burakBoyuk/gomulu-sistemler-kart/LICENSES/README.md

# Lisanslar

| Kapsam | Lisans | Dosya |
|---|---|---|
| Donanım (`hardware/`: şematik, PCB, BOM, üretim dosyaları) | CERN-OHL-P-2.0 | [`../LICENSE`](../LICENSE) |
| Yazılım (`firmware/`) | MIT | [`MIT.txt`](MIT.txt) |
| Doküman ve görseller (`docs/`, README) | CC BY 4.0 | [`CC-BY-4.0.txt`](CC-BY-4.0.txt) |

Telif: © 2026 Burak Kaan Böyük
