burakBoyuk/gomulu-sistemler-kart/hardware/es_brd_v000/es_brd_v000.csv

Reference | Qty | Value | Footprint | Link
C1,C3,C4,C6,C8,C9,C10,C13 | 8 | 100nF | Capacitor_SMD:C_0603_1608Metric | https://www.ozdisan.com/p/smt-smd-ve-mlcc-kapasitorler-184/samsung-cl10b104kb8nnnc-9739
C2,C5 | 2 | 220uF | Capacitor_SMD:CP_Elec_6.3x7.7 | https://www.ozdisan.com/p/aluminyum-kapasitorler-180/suscon-cd010m221e7dpkkkv00r-983562
C7,C11 | 2 | 18pF | Capacitor_SMD:C_0603_1608Metric | https://www.ozdisan.com/p/smt-smd-ve-mlcc-kapasitorler-184/viking-mcf03jtn500180-1086149
C12,C14 | 2 | 10uF | Capacitor_SMD:C_0603_1608Metric | https://www.ozdisan.com/p/smt-smd-ve-mlcc-kapasitorler-184/viking-mcf03mtx250106-1057176
D1 | 1 | LED_RED | LED_SMD:LED_0603_1608Metric | https://www.ozdisan.com/p/sinyal-ledler-tek-renkli-361/liteon-ltst-c190krkt-456428
D2 | 1 | LED_GRN | LED_SMD:LED_0603_1608Metric | https://www.ozdisan.com/p/sinyal-ledler-tek-renkli-361/liteon-ltst-c190krkt-456428
D3 | 1 | LED_BLE | LED_SMD:LED_0603_1608Metric | https://www.ozdisan.com/p/sinyal-ledler-tek-renkli-361/liteon-ltst-c190krkt-456428
D4 | 1 | LED_PWR | LED_SMD:LED_0603_1608Metric | https://www.ozdisan.com/p/sinyal-ledler-tek-renkli-361/liteon-ltst-c190krkt-456428
D5,D6 | 2 | M7 | Diode_SMD:D_SMA | https://www.ozdisan.com/p/dogrultucu-diyotlar-389/hottech-m7-ht-417206
J1 | 1 | Conn | Connector_JST:JST_XH_B2B-XH-A_1x02_P2.50mm_Vertical
J2 | 1 | SPI_CONN | Connector_PinHeader_2.54mm:PinHeader_1x04_P2.54mm_Vertical
J3 | 1 | PRG_CONN | Connector_PinHeader_2.54mm:PinHeader_1x04_P2.54mm_Vertical
J4 | 1 | I2C_CONN | Connector_JST:JST_XH_B4B-XH-A_1x04_P2.50mm_Vertical
J5 | 1 | PWR_CONN | Connector_PinHeader_2.54mm:PinHeader_1x04_P2.54mm_Vertical
J6 | 1 | PWR_IN | Connector_JST:JST_XH_S2B-XH-A_1x02_P2.50mm_Horizontal | https://www.ozdisan.com/p/pcb-konnektorler-310/connfly-ds1069-2mrw6sa-347995
J7 | 1 | RLY_OUT | Connector_Phoenix_MSTB:PhoenixContact_MSTBA_2,5_3-G-5,08_1x03_P5.08mm_Horizontal | https://www.ozdisan.com/p/gecmeli-klemensler-411/golten-2egtrc-5-08-03p-14-00ah-395410
K1 | 1 | HJR-3FF | Relay_THT:Relay_SPDT_SANYOU_SRD_Series_Form_C | https://www.ozdisan.com/p/genel-tip-roleler-403/tianbo-hjr-3ff-s-z-4-05vdc-415763
Q1 | 1 | BC817 | Package_TO_SOT_SMD:SOT-23 | https://www.ozdisan.com/p/discrete-transistorler-442/hottech-bc817-40-ht-417241
R1,R2,R3,R6,R7,R8,R10,R11,R12,R13 | 10 | 10K | Resistor_SMD:R_0603_1608Metric | https://www.ozdisan.com/p/smt-smd-ve-cip-direncler-194/royalohm-0603saj0103t5e-336243
R4,R5,R9,R15 | 4 | 1K | Resistor_SMD:R_0603_1608Metric | https://www.ozdisan.com/p/smt-smd-ve-cip-direncler-194/royalohm-0603saj0102t5e-336234
R14 | 1 | 330R | Resistor_SMD:R_0603_1608Metric | https://www.ozdisan.com/p/smt-smd-ve-cip-direncler-194/royalohm-0603saj0331t5e-336229
SW1 | 1 | BTN | Button_Switch_SMD:SW_SPST_Omron_B3FS-105xP
U1 | 1 | ATMEGA328PB-AU | Package_QFP:TQFP-32_7x7mm_P0.8mm | https://www.ozdisan.com/p/mikroislemciler-218/atmel-microchip-atmega328pb-au-537233
U2 | 1 | AMS1117-3.3 | Package_TO_SOT_SMD:SOT-223-3_TabPin2 | https://cdn.ozdisan.com/public/product/assets/AMS1117.pdf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
U3 | 1 | TMP1075D | Package_SO:SO-8_3.9x4.9mm_P1.27mm | https://www.ozdisan.com/p/sicaklik-sensorleri-927/texas-tmp1075dr-1086858
U4,U5 | 2 | LTV816 | Package_DIP:DIP-4_W7.62mm_SMDSocket_SmallPads | https://www.ozdisan.com/p/transistor-ve-fotovoltaik-cikisli-optokuplorler-189/liteon-ltv816s2tpc-v-g-951812
Y1 | 1 | 16MHz | Crystal:Crystal_SMD_3225-4Pin_3.2x2.5mm | https://www.ozdisan.com/p/kristaller-508/raltron-rh100-16-000-18-2020-tr-433869
