burakBoyuk/gomulu-sistemler-kart/docs/es_brd_v000-schematic.pdf

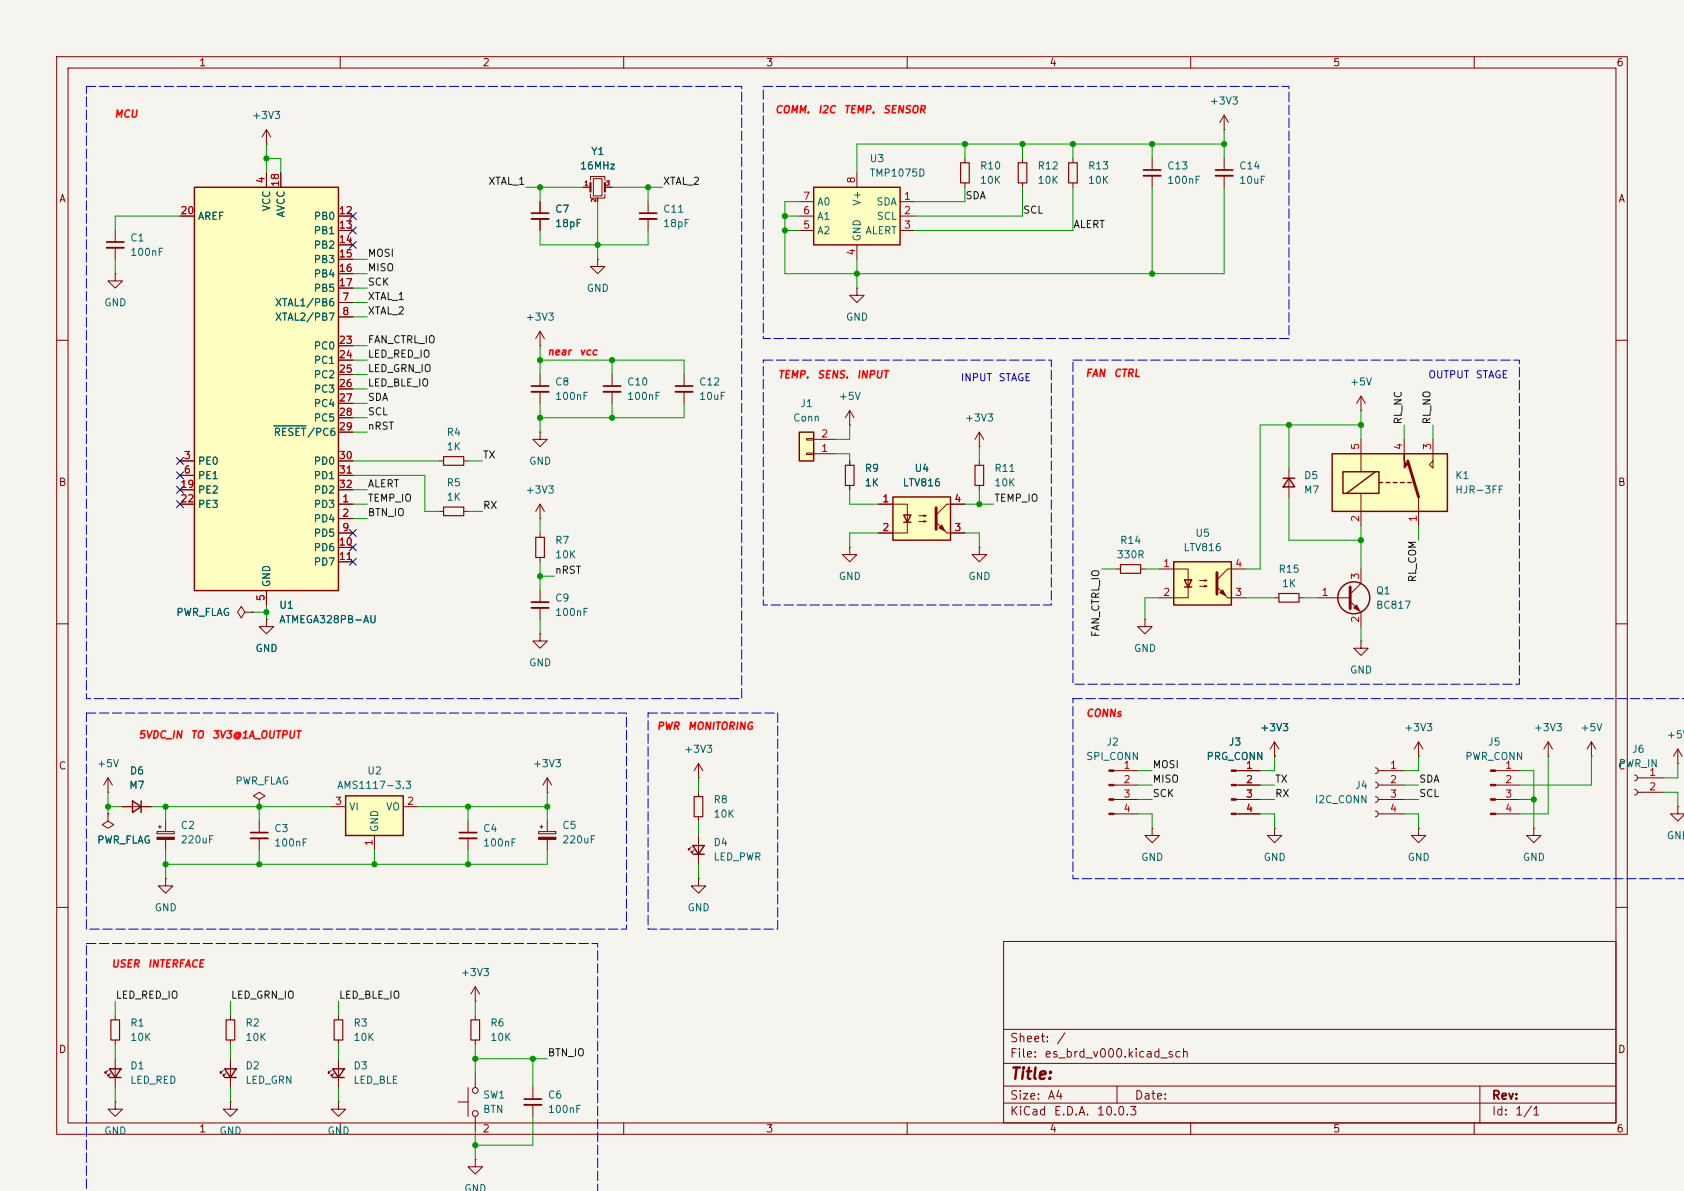
[picture p1: page 1]

Size: A4 | Rev:
KiCad E.D.A. 10.0.3 | Id: 1/1
