burakBoyuk/gomulu-sistemler-kart/hardware/es_brd_v000/es_brd_v000.kicad_pcb

## KiCad design hardware/es_brd_v000/es_brd_v000.kicad_pcb (2026-11-11)

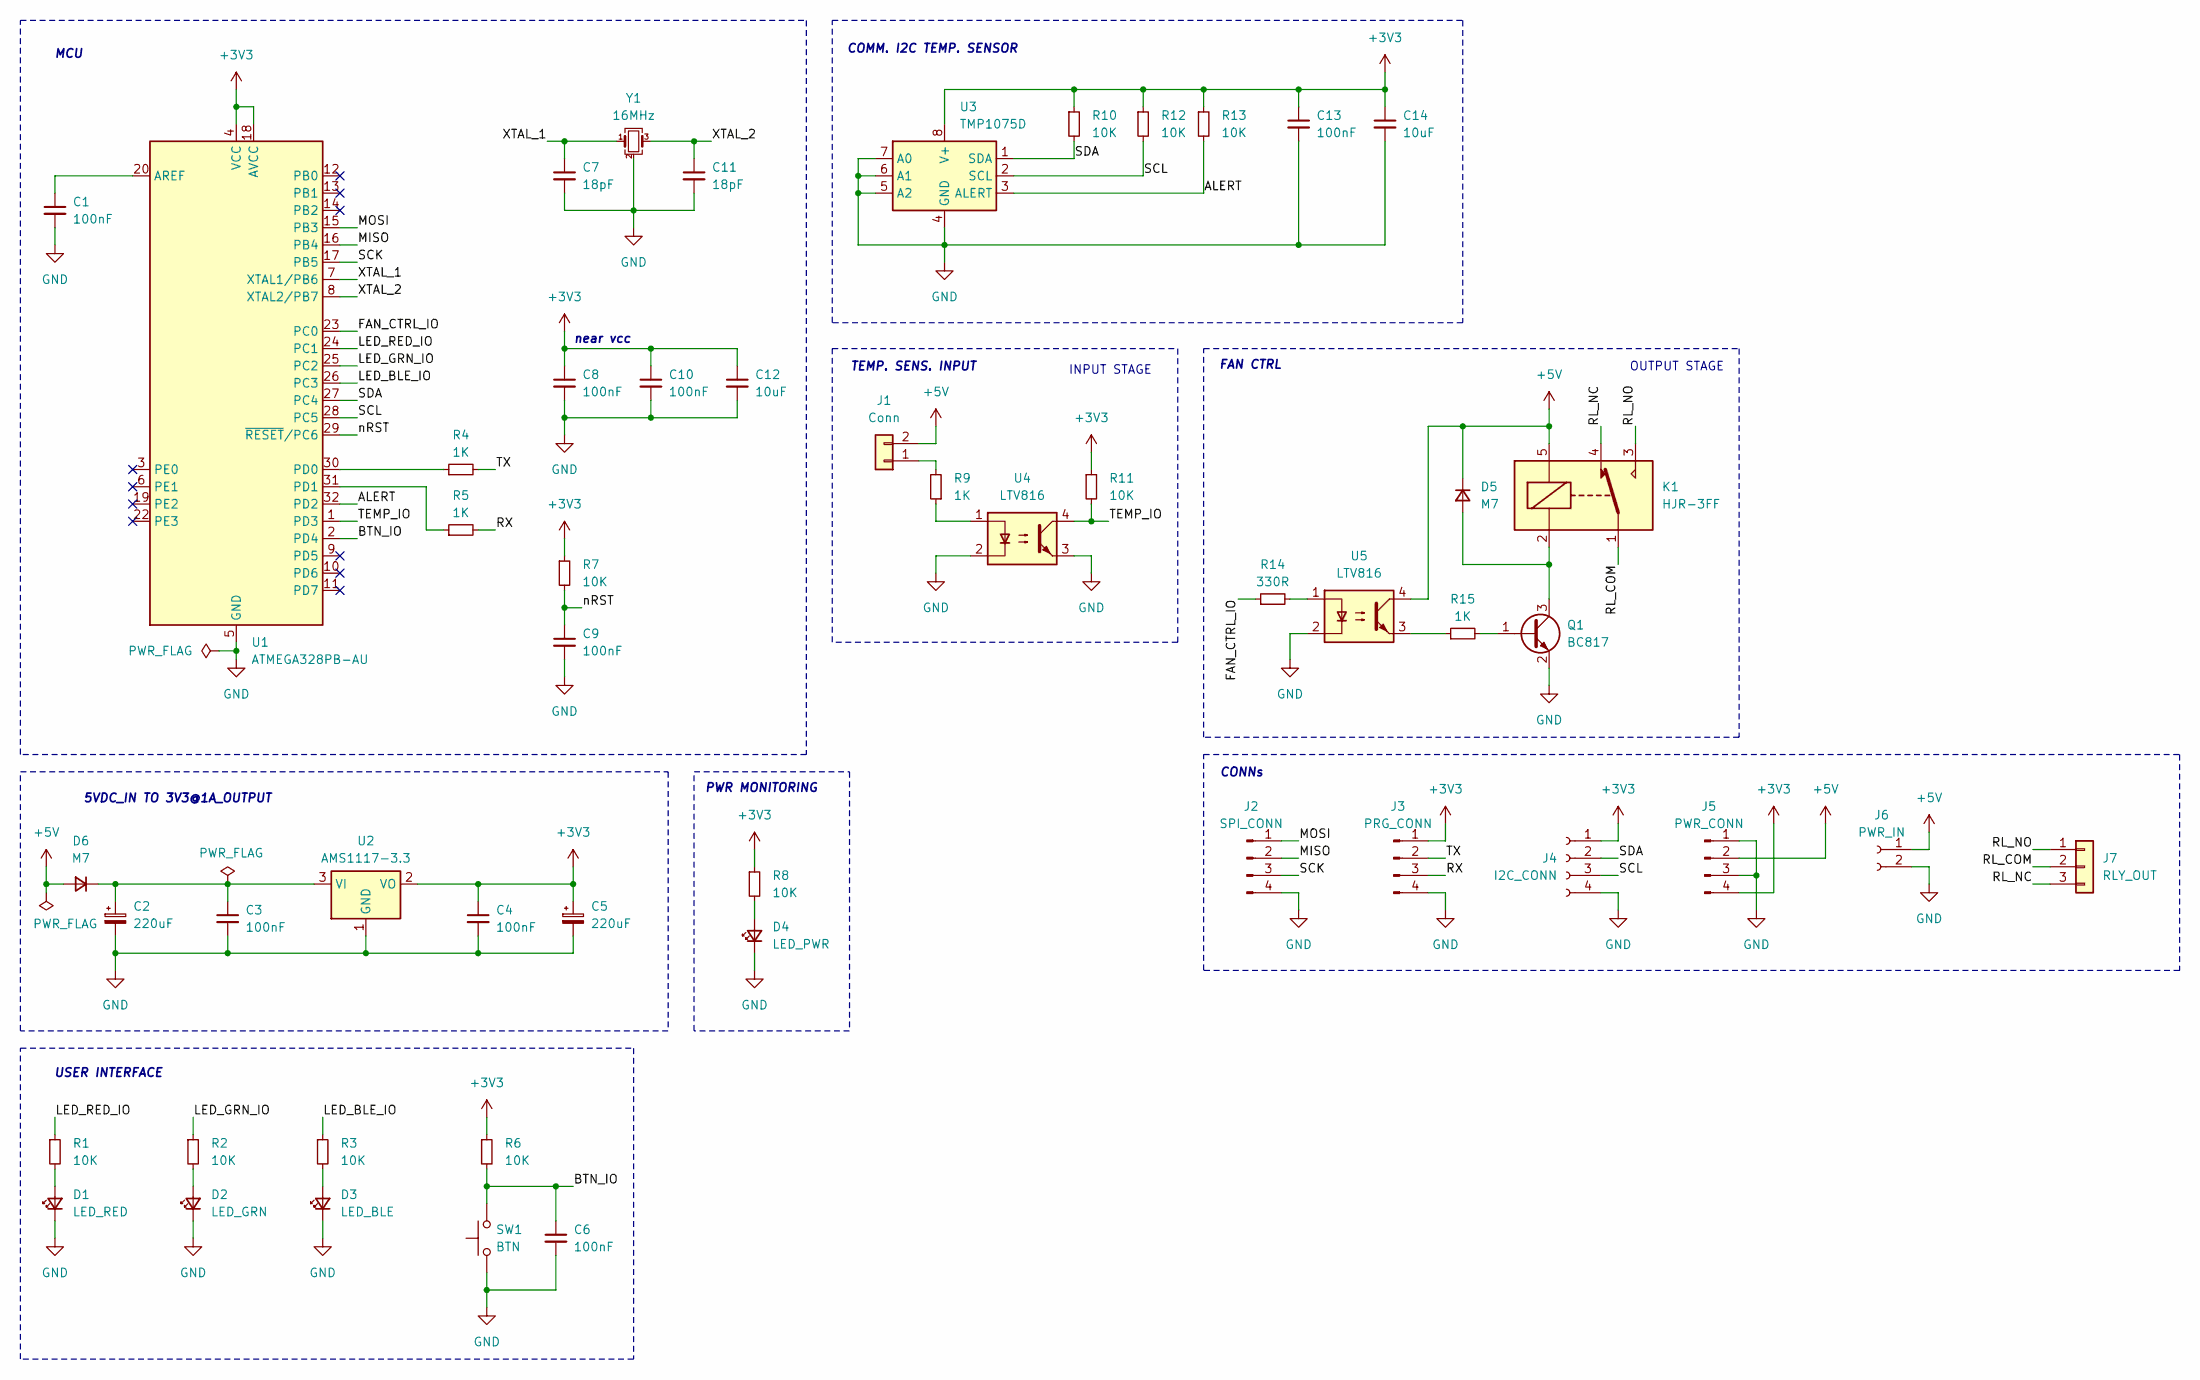
[picture p2: schematic es_brd_v000.kicad_sch]

Parts:
C1, C3, C4, C6, C8, C9, C10, C13: 100nF; C_0603_1608Metric
C2, C5: 220uF; CP_Elec_6.3x7.7
C7, C11: 18pF; C_0603_1608Metric
C12, C14: 10uF; C_0603_1608Metric
D1: LED_RED; LED_0603_1608Metric
D2: LED_GRN; LED_0603_1608Metric
D3: LED_BLE; LED_0603_1608Metric
D4: LED_PWR; LED_0603_1608Metric
D5, D6: M7; D_SMA
J1: Conn; JST_XH_B2B-XH-A_1x02_P2.50mm_Vertical
J2: SPI_CONN; PinHeader_1x04_P2.54mm_Vertical
J3: PRG_CONN; PinHeader_1x04_P2.54mm_Vertical
J4: I2C_CONN; JST_XH_B4B-XH-A_1x04_P2.50mm_Vertical
J5: PWR_CONN; PinHeader_1x04_P2.54mm_Vertical
J6: PWR_IN; JST_XH_S2B-XH-A_1x02_P2.50mm_Horizontal
J7: RLY_OUT; PhoenixContact_MSTBA_2,5_3-G-5,08_1x03_P5.08mm_Horizontal
K1: HJR-3FF; Relay_SPDT_SANYOU_SRD_Series_Form_C
Q1: BC817; SOT-23
R1, R2, R3, R6, R7, R8, R10, R11, R12, R13: 10K; R_0603_1608Metric
R4, R5, R9, R15: 1K; R_0603_1608Metric
R14: 330R; R_0603_1608Metric
SW1: BTN; SW_SPST_Omron_B3FS-105xP
U1: ATMEGA328PB-AU; TQFP-32_7x7mm_P0.8mm
U2: AMS1117-3.3; SOT-223-3_TabPin2
U3: TMP1075D; SO-8_3.9x4.9mm_P1.27mm
U4, U5: LTV816; DIP-4_W7.62mm_SMDSocket_SmallPads
Y1: 16MHz; Crystal_SMD_3225-4Pin_3.2x2.5mm

Connections:
+3V3: C4.1, C5.1, C8.1, C10.1, C12.1, C13.1, C14.1, J3.1, J4.1, J5.4, R6.1, R7.1, R8.1, R10.1, R11.1, R12.1, R13.1, U1.4 (VCC), U1.18 (AVCC), U2.2 (VO), U3.8 (V+)
+5V: D5.1 (K), D6.2 (A), J1.2, J5.2, J6.1, K1.5, U5.4
/ALERT: R13.2, U1.32 (PD2), U3.3 (ALERT)
/BTN_IO: C6.1, R6.2, SW1.2, U1.2 (PD4)
/FAN_CTRL_IO: R14.1, U1.23 (PC0)
/LED_BLE_IO: R3.1, U1.26 (PC3)
/LED_GRN_IO: R2.1, U1.25 (PC2)
/LED_RED_IO: R1.1, U1.24 (PC1)
/MISO: J2.2, U1.16 (PB4)
/MOSI: J2.1, U1.15 (PB3)
/RL_COM: J7.2, K1.1
/RL_NC: J7.3, K1.4
/RL_NO: J7.1, K1.3
/RX: J3.3, R5.2
/SCK: J2.3, U1.17 (PB5)
/SCL: J4.3, R12.2, U1.28 (PC5), U3.2 (SCL)
/SDA: J4.2, R10.2, U1.27 (PC4), U3.1 (SDA)
/TEMP_IO: R11.2, U1.1 (PD3), U4.4
/TX: J3.2, R4.2
/XTAL_1: C7.1, U1.7 (XTAL1/PB6), Y1.1
/XTAL_2: C11.1, U1.8 (XTAL2/PB7), Y1.3
/nRST: C9.1, R7.2, U1.29 (~RESET/PC6)
GND: C1.2, C2.2, C3.2, C4.2, C5.2, C6.2, C7.2, C8.2, C9.2, C10.2, C11.2, C12.2, C13.2, C14.2, D1.1 (K), D2.1 (K), D3.1 (K), D4.1 (K), J2.4, J3.4, J4.4, J5.1, J5.3, J6.2, Q1.2 (E), SW1.1, U1.5 (GND), U1.21 (GND), U2.1 (GND), U3.4 (GND), U3.5 (A2), U3.6 (A1), U3.7 (A0), U4.2, U4.3, U5.2, Y1.2 (G), Y1.4 (G)
unnamed: D1.2 (A), R1.2
unnamed: D2.2 (A), R2.2
unnamed: D3.2 (A), R3.2
unnamed: D4.2 (A), R8.2
unnamed: D5.2 (A), K1.2, Q1.3 (C)
unnamed: C2.1, C3.1, D6.1 (K), U2.3 (VI)
unnamed: J1.1, R9.2
unnamed: Q1.1 (B), R15.2
unnamed: R9.1, U4.1
unnamed: R14.2, U5.1
unnamed: R15.1, U5.3
unnamed: C1.1, U1.20 (AREF)
unnamed: R4.1, U1.30 (PD0)
unnamed: R5.1, U1.31 (PD1)

Notes on the sheet:
5VDC_IN TO 3V3@1A_OUTPUT
USER INTERFACE
OUTPUT STAGE
MCU
INPUT STAGE
PWR MONITORING
near vcc
FAN CTRL
COMM. I2C TEMP. SENSOR
TEMP. SENS. INPUT
CONNs

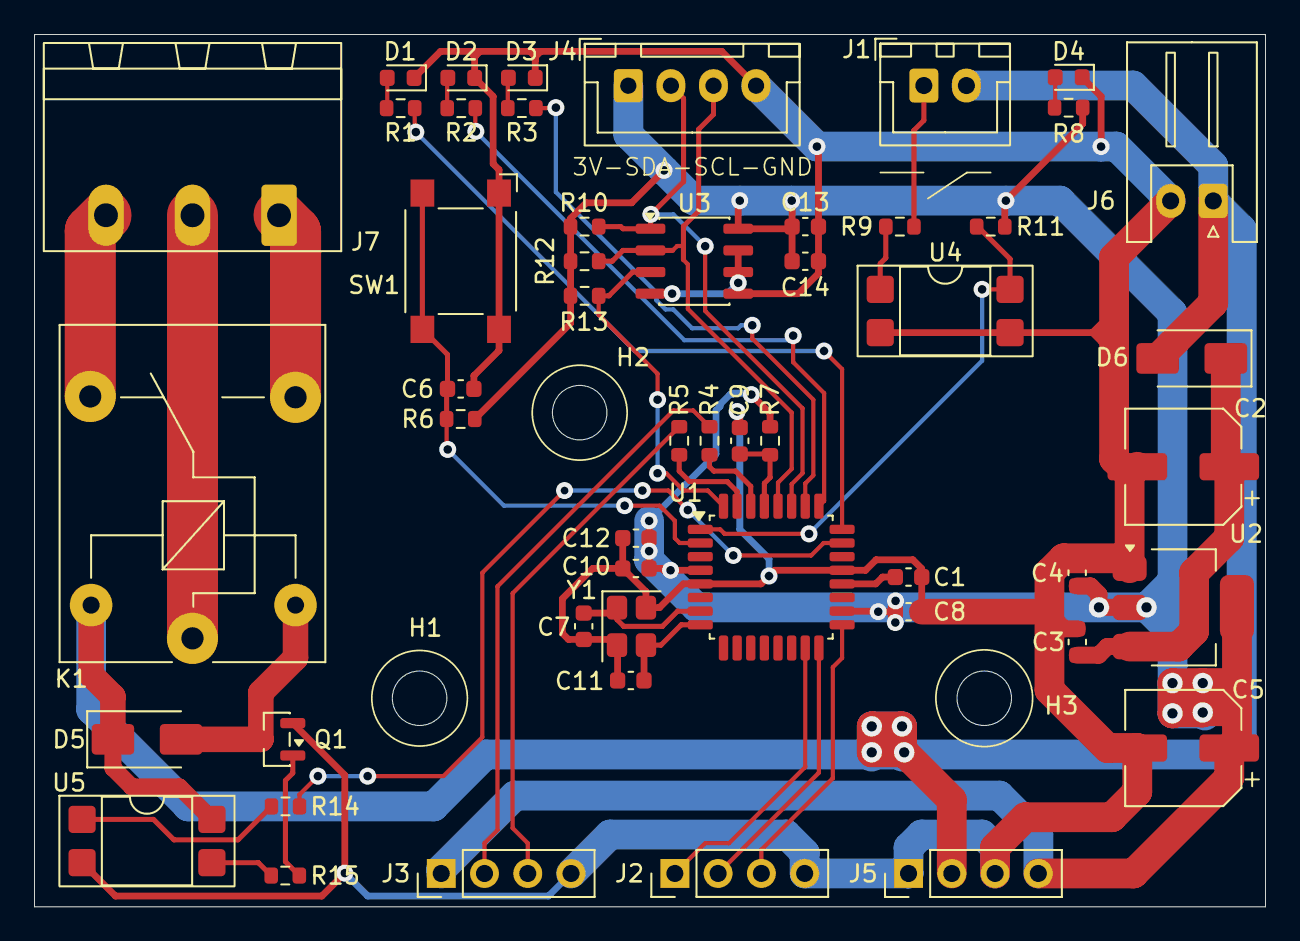
[picture p3: board es_brd_v000.kicad_pcb from above]

Board: 2 copper layers, 72.3 x 51.2 mm, 51 parts (0 on the bottom side), 37 nets.
