burakBoyuk/gomulu-sistemler-kart/(commit log)

2026-11-11 Add board KiCad project, licenses and README
    Hardware under CERN-OHL-P-2.0, firmware under MIT, docs under CC BY 4.0.
    [es_brd_v000.csv, es_brd_v000.kicad_pcb, es_brd_v000.kicad_sch]
2026-11-11 Switch relay to HJR-3FF 5 VDC and add schematic PDF
    The 12 V coil HJR-21FF did not match the 5 V supply. Drop shop
    tracking parameters from part links. Schematic PDF lives in docs/
    instead of release assets.
    [es_brd_v000.csv, es_brd_v000.kicad_pcb, es_brd_v000.kicad_sch]
